FYSETC/FYSETC-Cheetah-v2/examples/README.md

# Example

On these examples, you can find wiring diagram, firmware configuration. 

## Voron 0.1

Details check [github](https://github.com/FYSETC/FYSETC-Voron-0/tree/main/Firmware%26OS) or [gitee](https://gitee.com/fysetc-mirrors/FYSETC-Voron-0).

## Creality Ender-3

Check the README in folder `Ender-3`.

## Creality CR-10

Check the README in folder `CR-10`.
