FYSETC/FYSETC-Cheetah-v2/firmware/README.md

# Firmware

Cheetah v2.0 support both [Marlin](https://github.com/MarlinFirmware) and [Klipper](https://github.com/Klipper3d/klipper) firmware.
