FYSETC/FYSETC-Cheetah-v2/examples/CR10/README.md

# CR-10

We provide you an basic Marlin 2.0.9.3 based firmware(`firmware.bin`) for you, you can follow the instruction [here](https://github.com/FYSETC/FYSETC-Cheetah-v2#53--firmware-upload)( section) to upload the firmware, and we provide you its configuration files `configuration.h` and `configuration_adv.h`.

If you want to build the latest bugfix firmware, the configurations are [here](https://github.com/MarlinFirmware/Configurations/pull/682).

## Fan wiring

Connect controller fan to Cheetah2.x `FAN2` port
