FYSETC/FYSETC-Cheetah-v2/firmware/Klipper/README.md

# Klipper

## printer.cfg

This config is for our VORON 0.1 kit, you can change it base on your machine.
