FYSETC/FYSETC-Cheetah-v2/images/Cheetah_v20.png

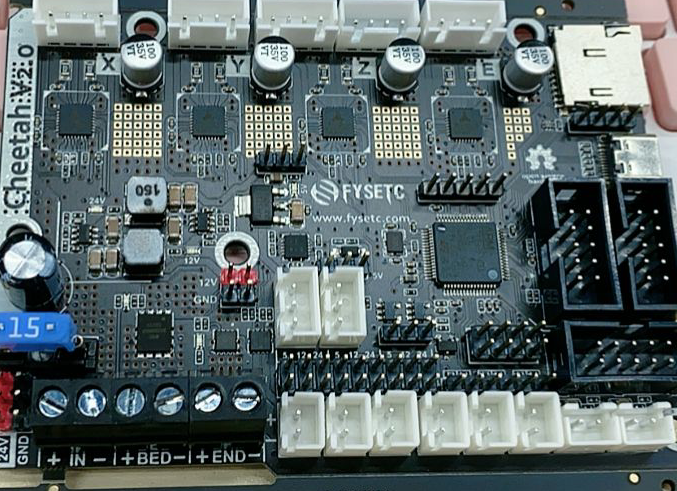
images/Cheetah_v20.png
