FYSETC/FYSETC-Cheetah-v2/(threads)

Thread 1 (2021-12-01):

#define PRINTCOUNTER: not worlking

Hagbard-84, 2021-12-01:
getting compile error:  Marlin\src\HAL\STM32\../../inc/../HAL/STM32/inc/SanityCheck.h:42:4: error: #error "Disable PRINTCOUNTER or choose another EEPROM emulation."

GerogeFu, 2021-12-01:
What version are you using ?

Hagbard-84, 2021-12-01:
latets marlin bugfix.

Hagbard-84, 2021-12-01:
the botloader: do i need to define in merlin ware i putt the firmware? if i build it from latest bugfix. ore do yhe boot loader place it att 0x08008000

Thread 2 (2021-12-15):

Connection issue with TFT24 v1.1

Morgan29880, 2021-12-15:
Hello,

I bought a Cheetah v2.0, that I would like to run with a TFT24 v1.1 screen. I managed to connect it in "Touch screen mod" (still got a "no printer attached" issue, but it's not a big deal I think).

What bothers me, i can't connect it either in "Marlin mode", with EXP1 and EXP2 ports...

I found EXP1 pin definition here, but does anyone have those for the other EXP ports please?

Thanks a lot.

GerogeFu, 2021-12-16:
Just update the pin def https://github.com/FYSETC/FYSETC-Cheetah-v2#43-pin-definition, and there is sch you can check https://github.com/FYSETC/FYSETC-Cheetah-v2/blob/main/hardware/Cheetah_Board%20V2.0_SCH.pdf

Morgan29880, 2021-12-16:
Thank you for your quick response.

yuriy-yarosh, 2022-06-26:
@Morgan29880 [this #2](https://github.com/FYSETC/FYSETC-Voron-0/issues/2) might be also helpful.

Thread 3 (2021-12-20):

mini lcd 12864 v2.1

petitphilou28, 2021-12-20:
hi,
i can switch on my fysetc lcd v2.1 on cheetah but nothing appear...

here is my setup...

[display]
lcd_type: uc1701
cs_pin: PB15
a0_pin: PB12
rst_pin: PB13
contrast: 63
encoder_pins: ^PC10, ^PC11
click_pin: ^!PC12
## Some micro-controller boards may require an spi bus to be specified:
#spi_bus: spi
## Alternatively, some micro-controller boards may work with software spi:
spi_software_miso_pin: PA6
spi_software_mosi_pin: PA7
spi_software_sclk_pin: PA5

#[output_pin beeper]
#pin: EXP2_10

[neopixel fysetc_mini12864]
pin: PB0
chain_count: 3
color_order: RGB
initial_RED: 0.1
initial_GREEN: 0.5
initial_BLUE: 0.0

[delayed_gcode setdisplayneopixel]
initial_duration: 1
gcode:
        SET_LED LED=fysetc_mini12864 RED=1 GREEN=1 BLUE=1 INDEX=1 TRANSMIT=0
        SET_LED LED=fysetc_mini12864 RED=1 GREEN=0 BLUE=0 INDEX=2 TRANSMIT=0
        SET_LED LED=fysetc_mini12864 RED=1 GREEN=0 BLUE=0 INDEX=3

lbibass, 2022-08-01:
How did you fix this?

Closed 2022-06-26.

Thread 4 (2022-01-20):

Getting Klipper to run on Ender3 hardware

webhdx, 2022-01-20:
Hello
I was looking for a new board for my first revision Ender 3 which used old  Creality v1.1.4 board. Of course my first choice was SKR Mini E3 v3 but then I found FYSETC Cheetah v2 which has a few advantages in my opinion. I want ahead and bought one.

I'm trying to get Klipper to run on my machine but I noticed the provided configuration files are not 100% correct for Ender3. I had to make a few changes:

```diff
@@ -1,129 +1,195 @@
 [mcu]
 ##	Obtain mcu value by "ls -l /dev/serial/by-id/"
-serial: /dev/serial/by-id/usb-Klipper_stm32f401xc_4C004E000C51383336383937-if00
+serial: /dev/serial/by-id/usb-Klipper_stm32f401xc_150036001951383336383937-if00

 [stepper_x]
 step_pin: PC0
-dir_pin: PC1
+dir_pin: !PC1
 enable_pin: !PA8
 rotation_distance: 40
 microsteps: 16
 endstop_pin: ^PB4
 position_endstop: 0
-position_max: 200
+position_max: 240
 homing_speed: 50

 [tmc2209 stepper_x]
 uart_pin: PA3
 tx_pin: PA2
 uart_address: 0
 run_current: 0.800
 hold_current: 0.500
 stealthchop_threshold: 250

 [stepper_y]
 step_pin: PC14
 dir_pin: !PC13
 enable_pin: !PC15
 rotation_distance: 40
 microsteps: 16
-endstop_pin: ^PB3
+endstop_pin: ^PC8
 position_endstop: 0
-position_max: 200
+position_max: 240
 homing_speed: 50

 [tmc2209 stepper_y]
 uart_pin: PA3
 tx_pin: PA2
 uart_address: 2
 run_current: 0.800
 hold_current: 0.500
 stealthchop_threshold: 250

 [stepper_z]
 step_pin: PB9
 dir_pin: PB8
 enable_pin: !PC2
 rotation_distance: 8
 microsteps: 16

endstop_pin: ^PB1
position_endstop: 0
position_max: 250

 [tmc2209 stepper_z]
 uart_pin: PA3
 tx_pin: PA2
 uart_address: 1
 run_current: 0.800
 hold_current: 0.500
 stealthchop_threshold: 5

 [extruder]
 step_pin: PB2
 dir_pin: !PA15
 enable_pin: !PD2
-rotation_distance: 33.500
+rotation_distance: 33.683
 microsteps: 16

 nozzle_diameter: 0.400
 filament_diameter: 1.750
 heater_pin: PC6
 sensor_type: EPCOS 100K B57560G104F
 sensor_pin: PC4
 control: pid
 pid_kp: 21.527
 pid_ki: 1.063
 pid_kd: 108.982
 min_temp: 0
 max_temp: 250

 [tmc2209 extruder]
 uart_pin: PA3
 tx_pin: PA2
 uart_address: 3
 run_current: 1.0
 hold_current: 0.500
 stealthchop_threshold: 5

 [heater_bed]
 heater_pin: PC7
 sensor_type: EPCOS 100K B57560G104F
 sensor_pin: PC5
 control: pid
 pid_kp: 54.027
 pid_ki: 0.770
 pid_kd: 948.182
 min_temp: 0
 max_temp: 130

 #fan for printed model FAN0
 [fan]
 pin: PA14

 #fan for hotend FAN1
-#[heater_fan my_nozzle_fan]
-#pin: PA13
+[heater_fan hotend_fan]
+pin: PA13
+heater: extruder
+heater_temp: 50.0
+
+#fan for mainboard FAN2
+[fan_generic mcu_fan]
+pin: PA1

 [printer]
 kinematics: cartesian
 max_velocity: 300
 max_accel: 3000
 max_z_velocity: 5
 max_z_accel: 100

 [board_pins]
 aliases:
     # EXP1 header
     EXP1_1=<5V>,  EXP1_3=<RST>, EXP1_5=PA7,  EXP1_7=PA4,  EXP1_9=PA5,
     EXP1_2=<GND>, EXP1_4=PC3,   EXP1_6=PC11, EXP1_8=PC10, EXP1_10=PA6,

     # EXP2 header
     EXP2_1=<5V>,  EXP2_3=PB7, EXP2_5=PB14, EXP2_7=PB12, EXP2_9=PC12,
     EXP2_2=<GND>, EXP2_4=PB6, EXP2_6=PB13, EXP2_8=PB15, EXP2_10=PC9,

     # EXP3 header
     EXP3_1=PC9,  EXP3_3=PC10, EXP3_5=PC11, EXP3_7=PB12, EXP3_9=<GND>,
     EXP3_2=PC12, EXP3_4=PB14, EXP3_6=PB13, EXP3_8=PB15, EXP3_10=<5V>
     # Pins EXP1_4, EXP1_8, EXP1_6 are also MISO, MOSI, SCK of bus "spi2"

+[display]
+lcd_type: st7920
+cs_pin: EXP3_7
+sclk_pin: EXP3_6
+sid_pin: EXP3_8
+encoder_pins: ^EXP3_5, ^EXP3_3
+click_pin: ^!EXP3_2
+
+[output_pin beeper]
+pin: EXP3_1
```

This is a good starting point if someone is struggling to get Ender3 hardware to work properly.

I have multiple isues though:
- I can't get internal MCU temperature sensor to work. Since Ender3 has additional fan for the mainboard I'd like to run it only if the temperature reaches some temperature. I tried configuring custom temperature sensor:
```ini
[temperature_sensor mcu_temp]
sensor_type: temperature_mcu
sensor_mcu: mcu
min_temp: 0
max_temp: 100
```

But I get `MCU 'mcu' shutdown: Not a valid ADC pin` error.
- Can't get BLTouch to work - this is the most frustrating one. I'm using v3.0 3D Touch clone on my setup and it was working properly with previous board. Now with Cheetah v2 Klipper can't control the probe, it doesn't react to any `BLTOUCH_DEBUG` commands. My config for BLTouch looks like this:
```ini
[bltouch]
sensor_pin = ^PB1
control_pin = PA0
x_offset: -45
y_offset: -8
z_offset: 3.2
samples: 2
speed: 10.0
probe_with_touch_mode: true
stow_on_each_sample: false
```

Any idea how to deal with these issues, especially BLTouch?

Thread 5 (2022-05-05):

MCU Temperature sensor

vjeko2404, 2022-05-05:
When I define the MCU temperature sensor in printer.cfg I get the MCU 'mcu' shutdown: Not a valid ADC pin error.
That should work with the STM32 pcu. Is the internal temp sensor included?

```
[temperature_sensor mcu_temp]
sensor_type: temperature_mcu
min_temp: 0
max_temp: 100
```

ayufan, 2022-06-13:
I created a fix in here: https://github.com/Klipper3d/klipper/pull/5572

Thread 7 (2022-07-01):

Cheetah V2 - Enable Printcount

V1ntex, 2022-07-01:
Hello, please help me, i want to enable PRINTCOUNT, but i take an error:

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

yzheka, 2022-09-30:
check [this](https://github.com/FYSETC/FYSETC-Cheetah-v2/issues/1). Actually you can see all in error message

Thread 8 (2022-09-04):

EXP1 and EXP2 are mirrored

RobTS, 2022-09-04:
After spending plenty of time trying to get one of your 12864 displays connected, I have figured out the reason: The mapping of EXP1 and EXP2 (and possibly EXP3 too, haven't checked) is inverted (e.g. 1 is 10, 10 is 1, and so on). When trying to set up your 12864 according to the [default klipper config for lcds](https://github.com/Klipper3d/klipper/blob/master/config/sample-lcd.cfg), this leads to klipper not being able to run due to errors such as `pin EXP1_3 is reserved for <RST>` preventing startup. When invering the pin headers, the display starts working flawlessly.

lbibass, 2022-11-11:
@RobTS do you happen to have your fixed config? Do you mind sending it here?

Thread 10 (2022-10-11):

BL touch wiring image is incorrect on main git page

PhilMaddox, 2022-10-11:
The image showing the connection for a BL touch is incorrect and will damage the BLT and / or control board !!!

this is what it should be >>
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

voronoff2803, 2023-03-18:
you should use the following config:
[bltouch]
sensor_pin: ^PA0
control_pin: PB1

Thread 11 (2022-10-17):

extruder thermistor is not accurate

yzheka, 2022-10-17:
on the tempertaure grapth the line is not straight and there are a lot +/-1 degree of celsius lag which causes inconsitent extrusion. after switching to skr pico with the same rest of hardware I can see +/- 0.2 degree of celsius lag.

Thread 12 (2023-01-05):

Example connection for neopixel

HitLuca, 2023-01-05:
In the readme there is a mention of neopixel support, but there is no indication of where it should be used. It is also mentioned that the board pins can be used as 4th fan, but still no 2-pin connector that seems suitable can be seen in the pictures

Thread 13 (2023-02-15):

Cheetah-v2 short?

Yuxiang-Ma, 2023-02-15:
I am using Cheetash-v2 as control board for Voron 0.1. I found that the heaters does not work and the cooling fans will not start when I was running the intial startup for voron 0.1.

I tested the output pins of the cheetah-v2 board, and both the power and ground pins for heaters and cooling fans give me 24V. Then I turn off the power and tested the resistance of those pins. It seems they are all good and no short is happening.

I am really not sure if there is a short happening, since the reisistances are normal and I do not think there was any magic gas leaking when I first boot the board. So I am not sure about what to do. Is there anything I can do to find out the issue? Or should I just buy a new board?

Thread 15 (2023-03-12):

Fan pins are flipped

Petertjedmn, 2023-03-12:
+ and - of the fans are the flipped. I solved this on my board by just flipping the white sockets for the fans. You can get them off the board with tweezers.

voronoff2803, 2023-03-18:
you should use the following config:
[bltouch]
sensor_pin: ^PA0
control_pin: PB1

Thread 16 (2023-03-19):

Difference between 5V, DC5V and USB_5V?

kozross, 2023-03-19:
The image below shows three power pins that are grouped on the board:

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

I'm unable to tell what the difference between these pins is. They all seem to do the same thing: provide 5V power. However, they're separate, and named differently, so what exactly is the difference, if any?

Context for this question: I am trying to power a SBC running Klipper, and would like to know which of these pins I can use for 5V power.

Thread 17 (2024-02-03):

Wiki shows wrong pinout (RGB and PWR-PROBE flipped)

devdrik, 2024-02-03:
The wiki for the cheetah 2 shows a wrong pinout:
In [this wiki](https://wiki.fysetc.com/Cheetah_Board_V20/#43-pin-definition) the [pinout image](https://wiki.fysetc.com/images/Cheetah_V2.0_pinout.jpg) has the RGB and PWR-PROBE pins switched. This lead to me killing my LEDs. The GitHub readme already has a correct version of the image [this one](https://github.com/FYSETC/FYSETC-Cheetah-v2/blob/main/images/Cheetah_V2.0_pinout.jpg)

Please update the wiki!

ashthespy, 2024-03-21:
@devdrik Did you get manage to get this working? I ran into the same issue, and thankfully didn't manage to shot out my LEDs.
LEDs work fine on other MCUs, but I couldn't get it working with klipper. Any hints?

devdrik, 2024-03-21:
@ashthespy Yes, when I used the correct pins ([this picture shows the correct LED pins](https://github.com/FYSETC/FYSETC-Cheetah-v2/blob/main/images/Cheetah_V2.0_pinout.jpg)) everything worked fine.
