FYSETC/FYSETC-Cheetah-v2/hardware/Cheetah_Board V2.0_SCH.pdf

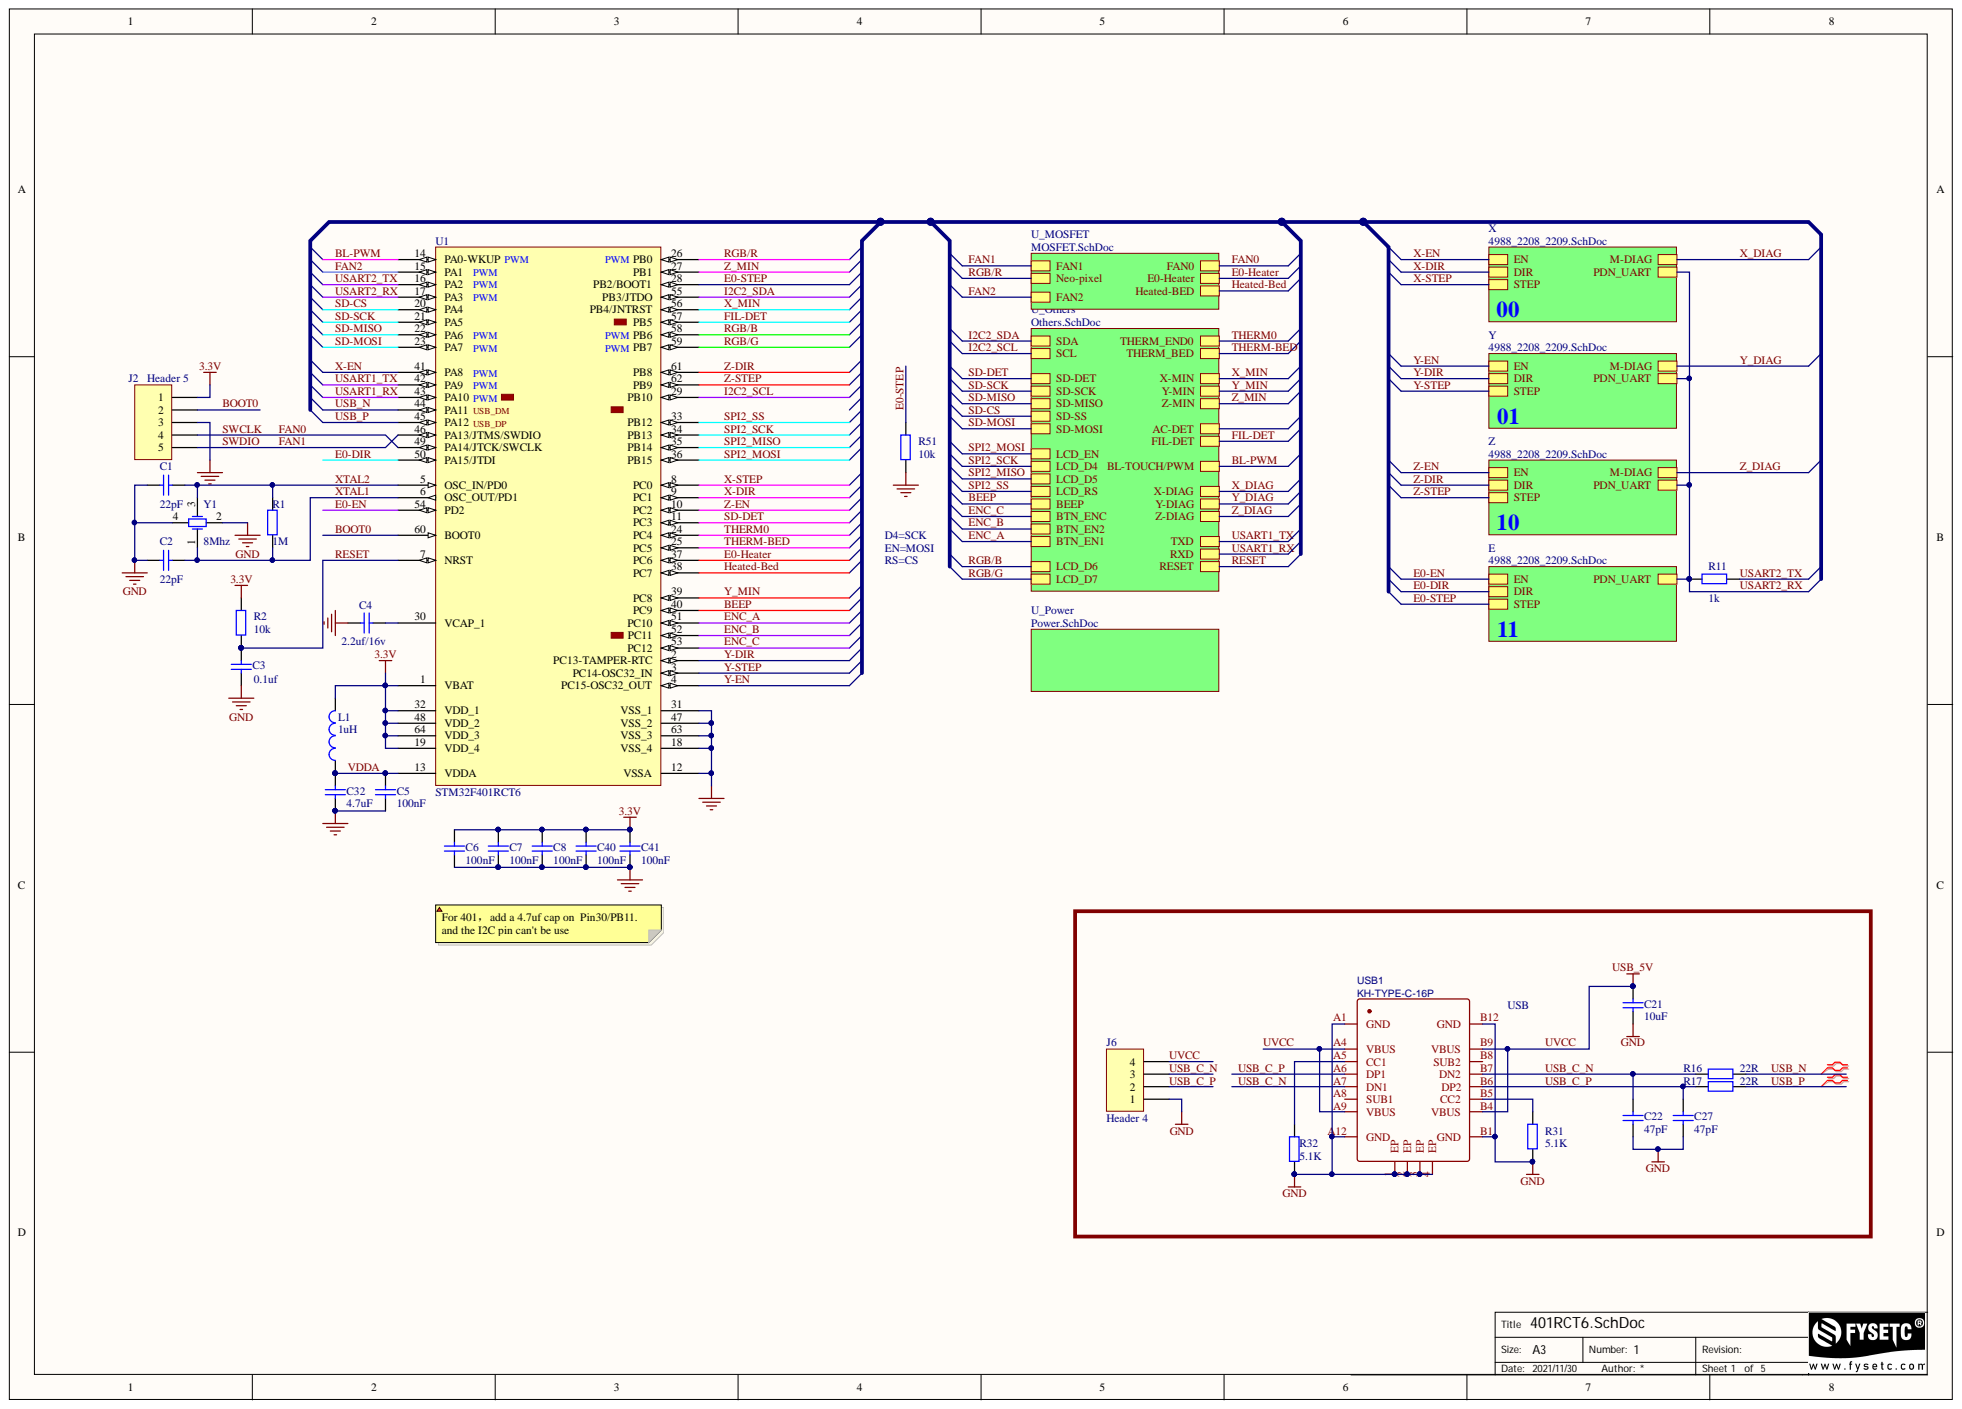
[picture p11: page 1]

For 401，add a 4.7uf cap on Pin30/PB11.
and the I2C pin can't be use

401RCT6.SchDoc Title

Size: A3 | Number: | Revision:

Date: Author: | | Sheet of

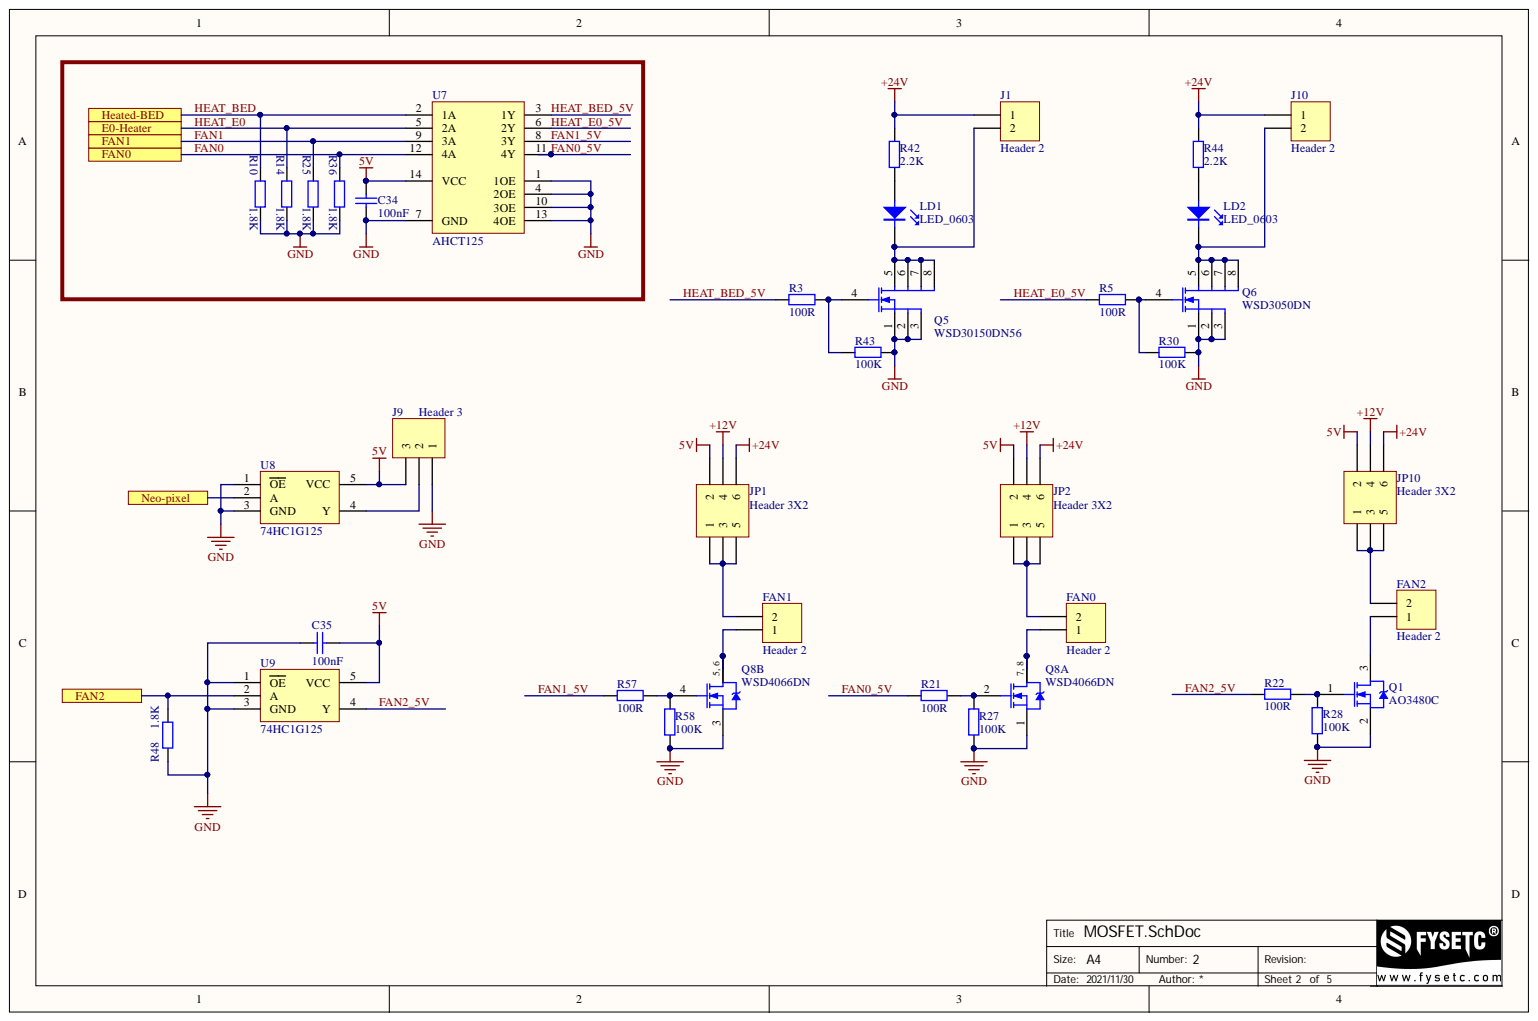
[picture p12: page 2]

HEAT_E0
FAN1
FAN0

5V | VCC 14

MOSFET.SchDoc Title

Size: A4 | Number: 2 | Revision:

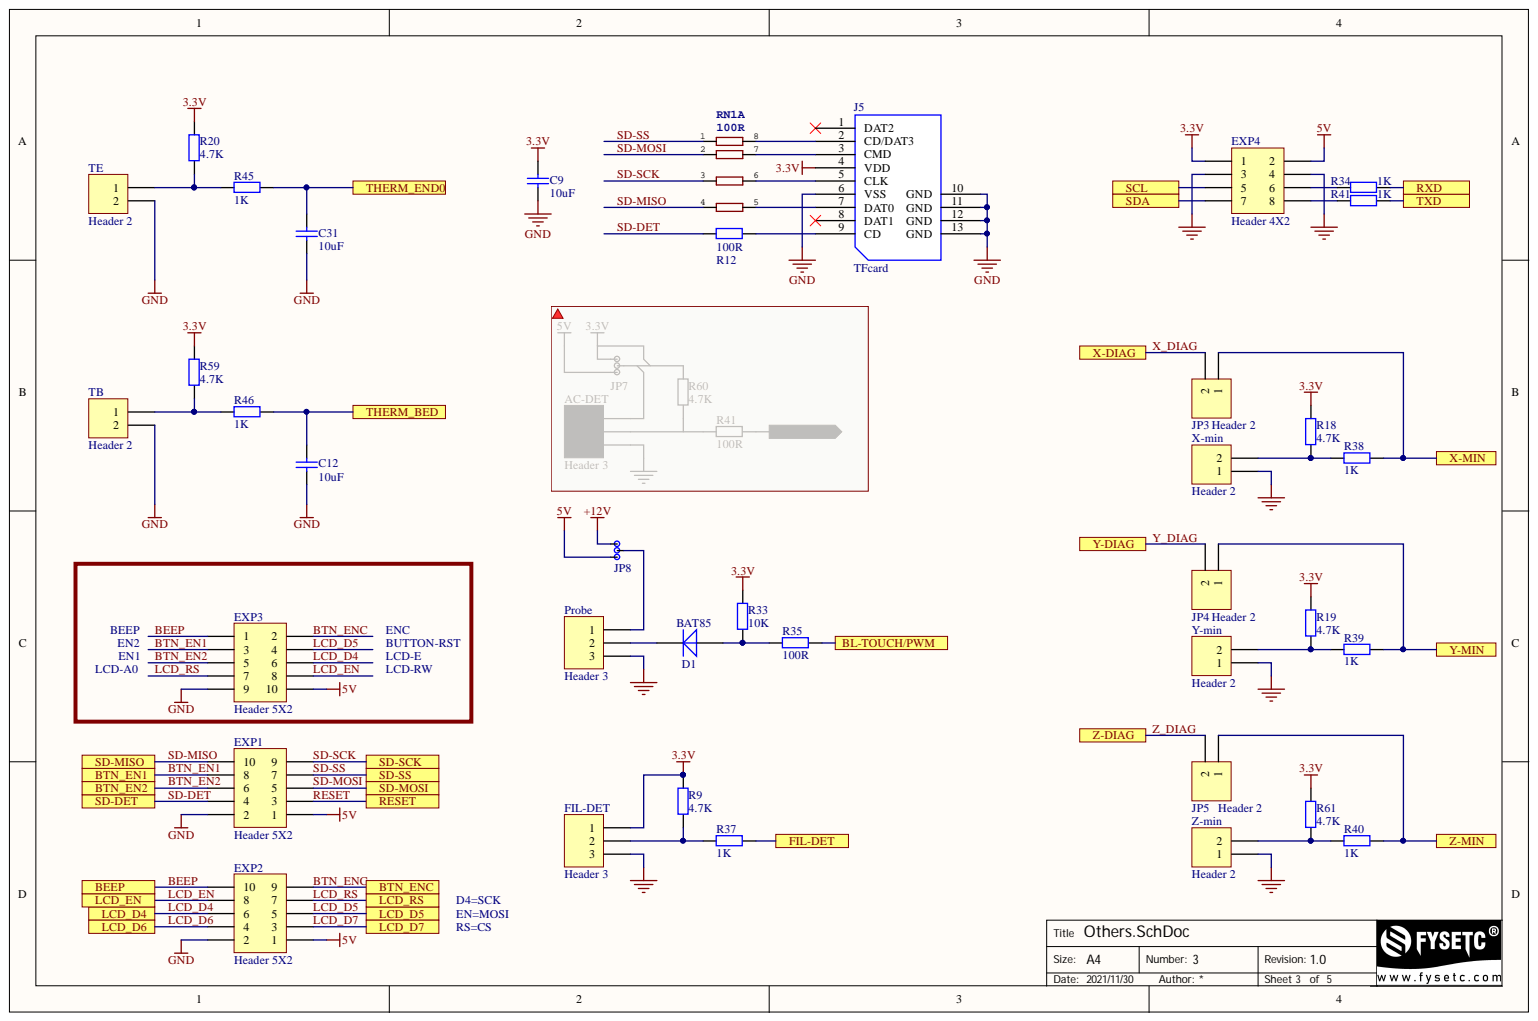
[picture p13: page 3]

SDA | TXD

BTN_EN2 | SD-MOSI
SD-DET | RESET

LCD_EN | | LCD_RS
LCD_D4 | | LCD_D5
LCD_D6 | | LCD_D7

LCD_D4 | | | | LCD_D5

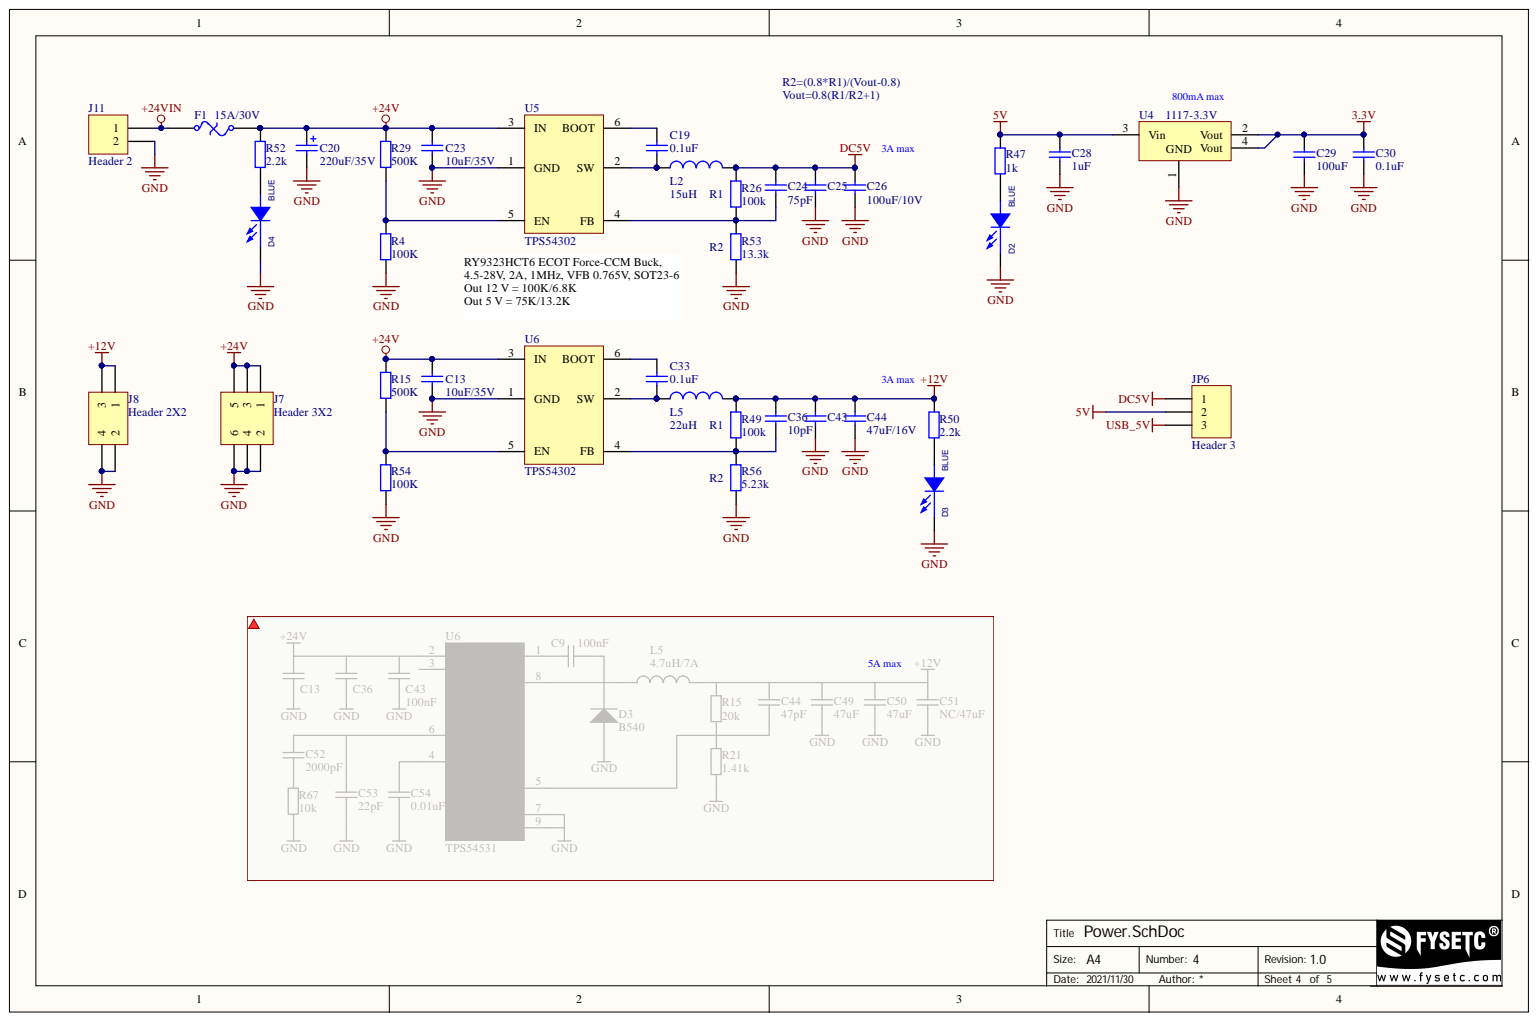
[picture p14: page 4]

Power.SchDoc Title

Size: A4 | Number: 4 | Revision: 1.0

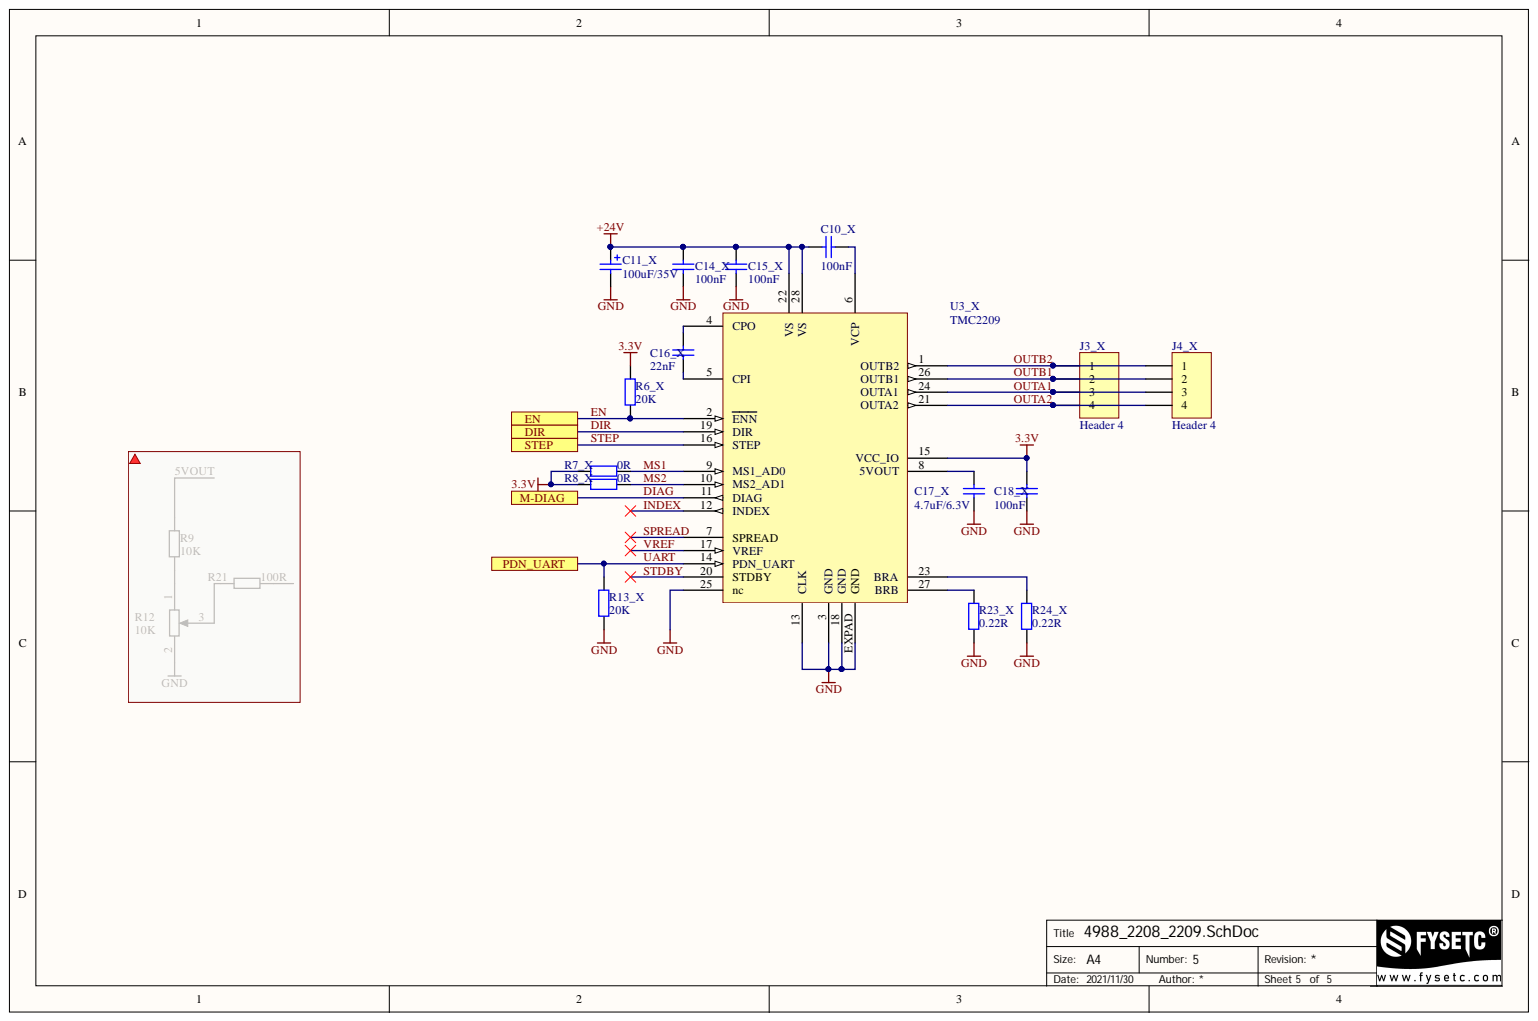
[picture p15: page 5]

4988_2208_2209.SchDoc Title

Size: A4 | Number: 5 | Revision: *

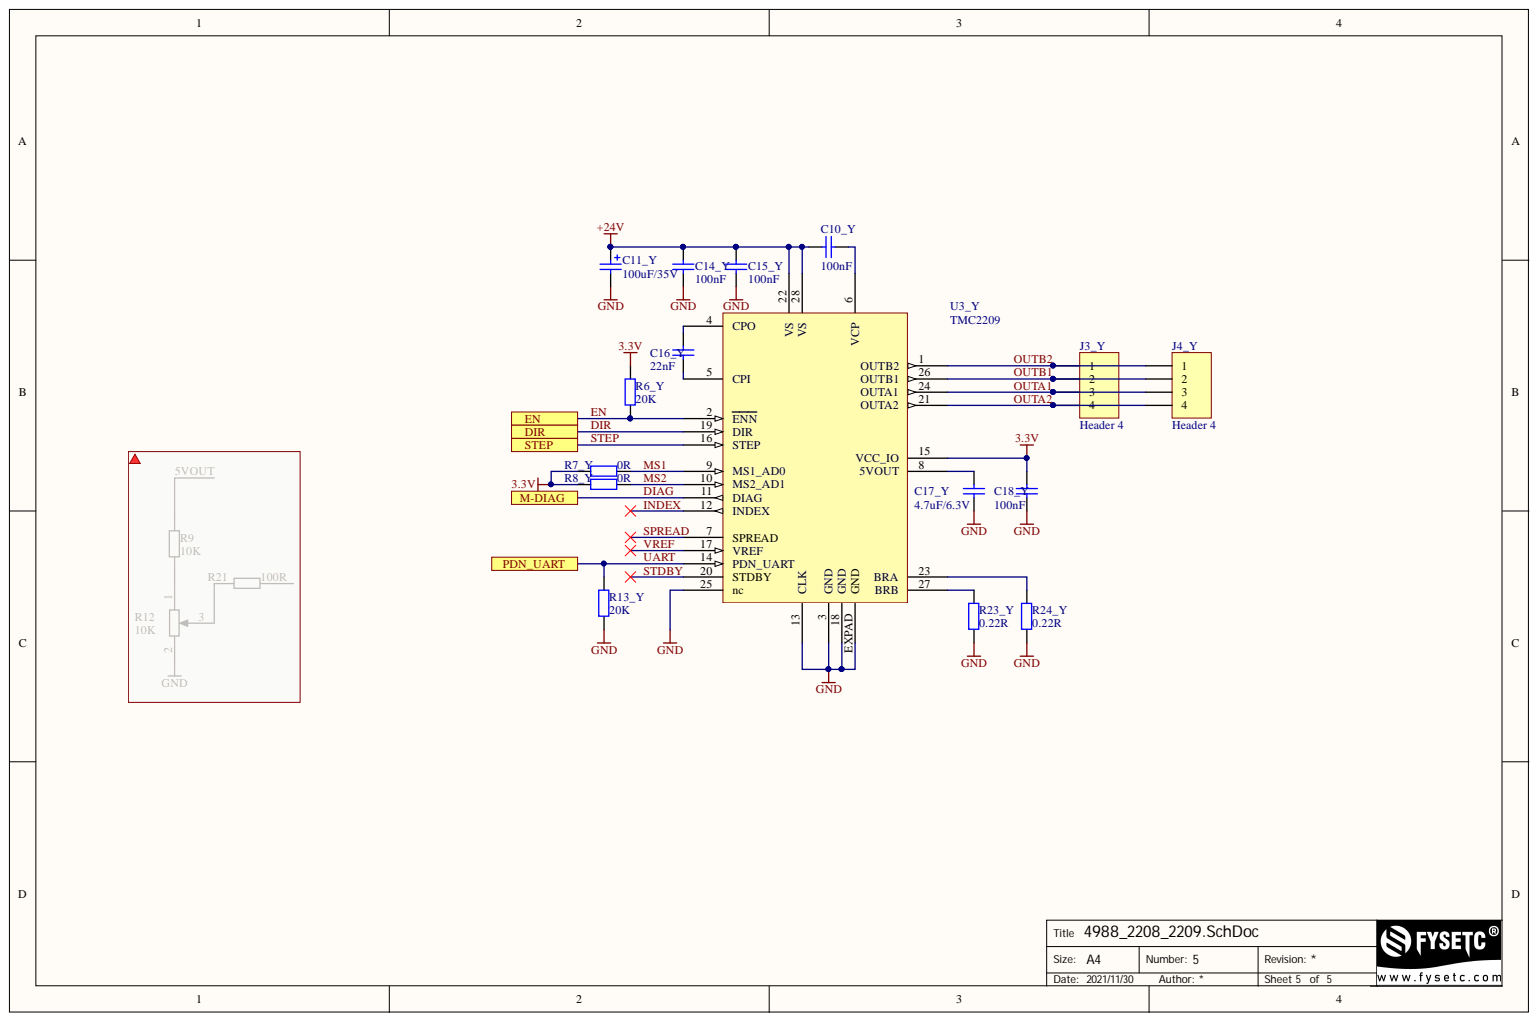
[picture p16: page 6]

4988_2208_2209.SchDoc Title

Size: A4 | Number: 5 | Revision: *

4988_2208_2209.SchDoc Title

Size: A4 | Number: 5 | Revision: *

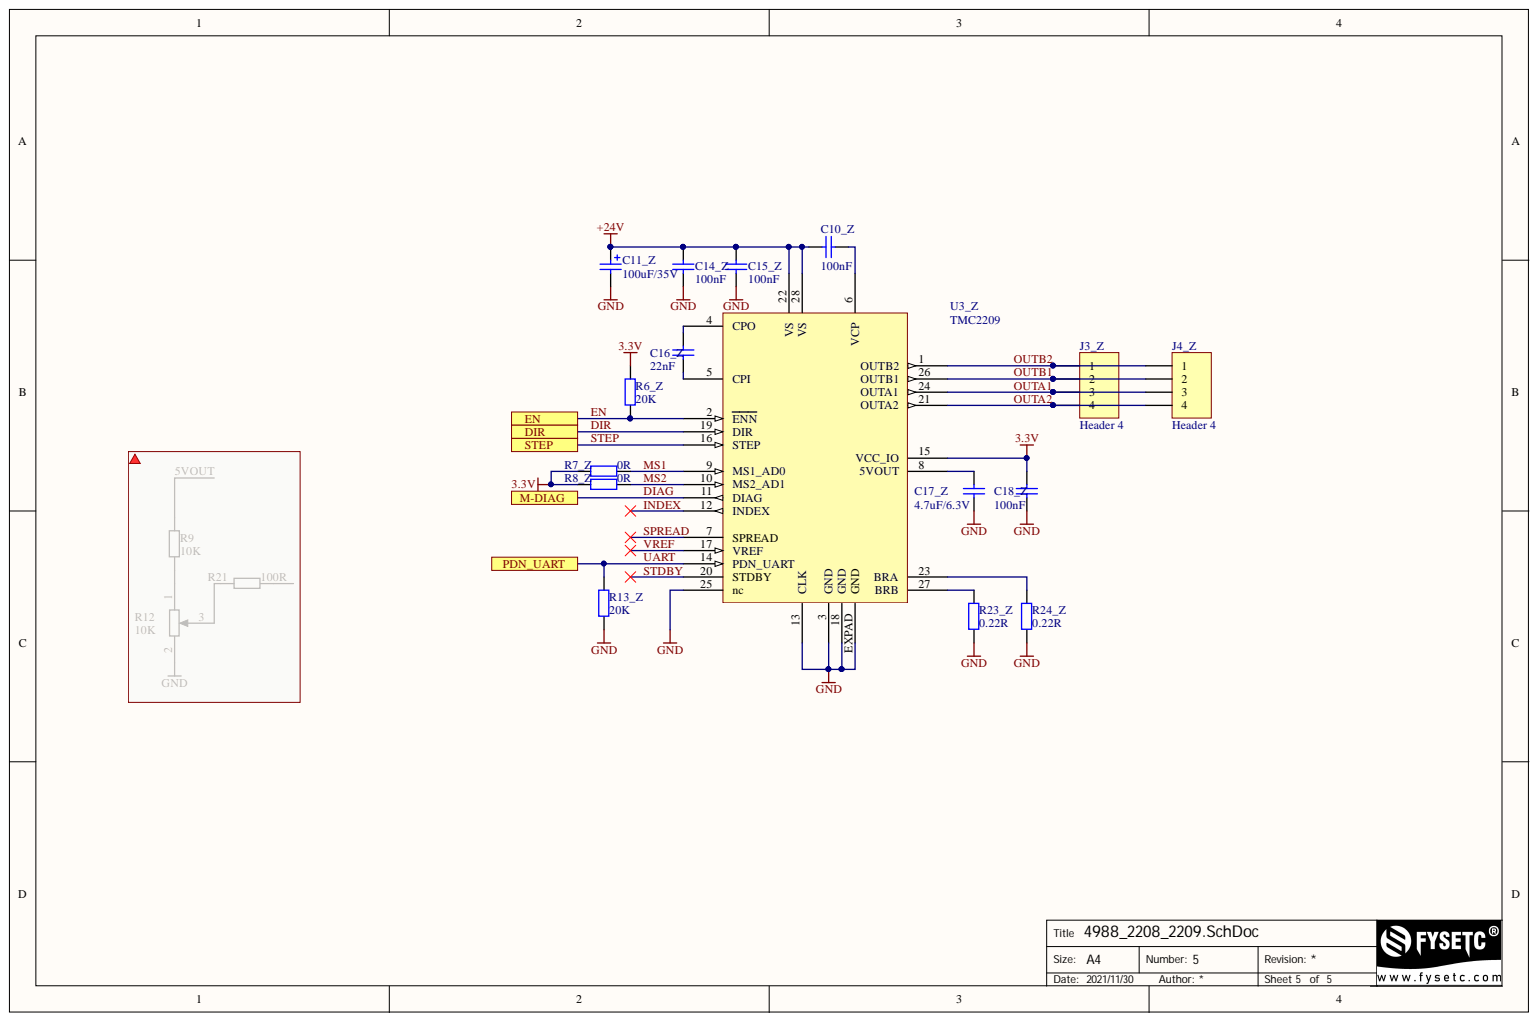
[picture p17: page 8]

4988_2208_2209.SchDoc Title

Size: A4 | Number: 5 | Revision: *
