FYSETC/FYSETC-Cheetah-v2/hardware/Composite Drawing.pdf

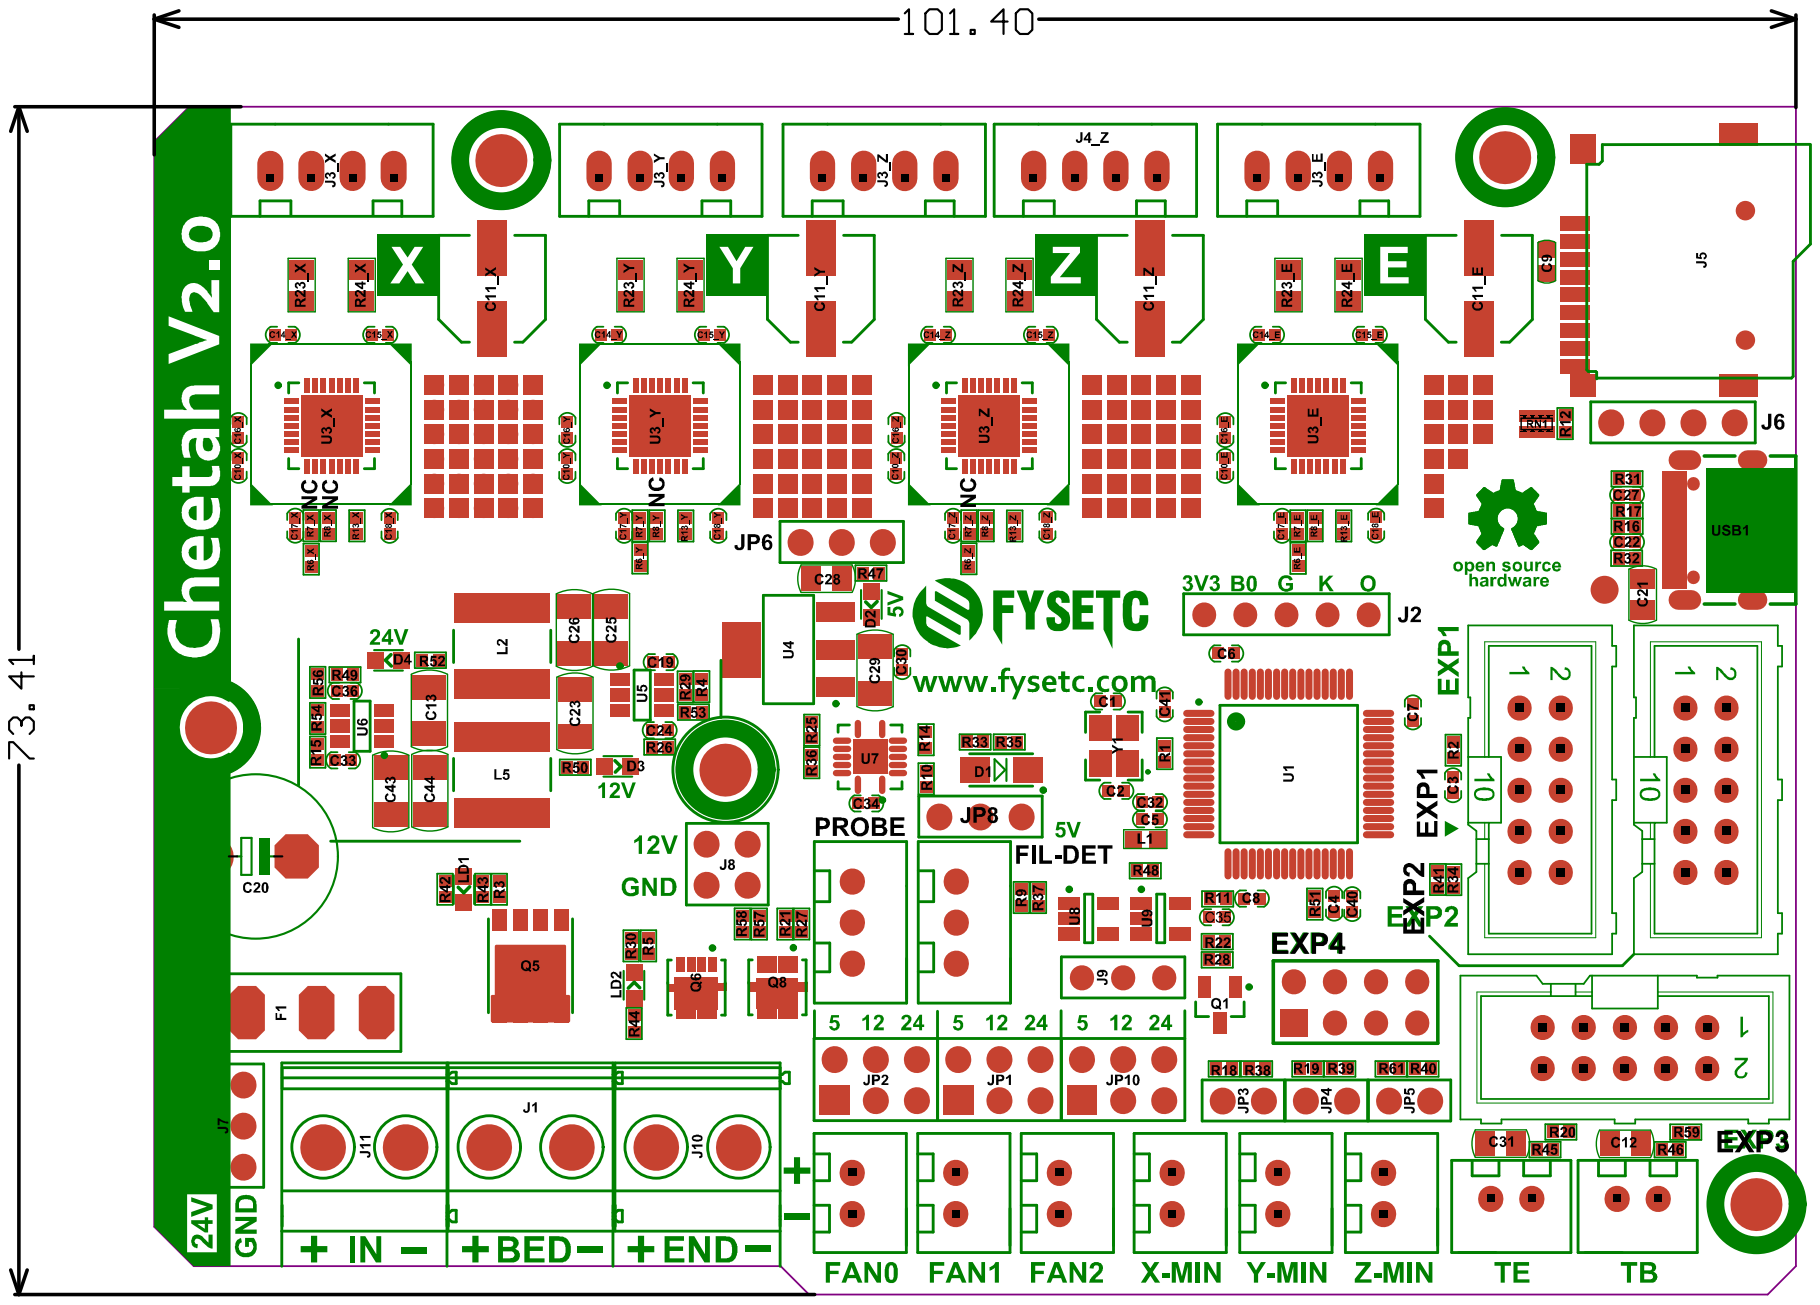
[picture p18: page 1]

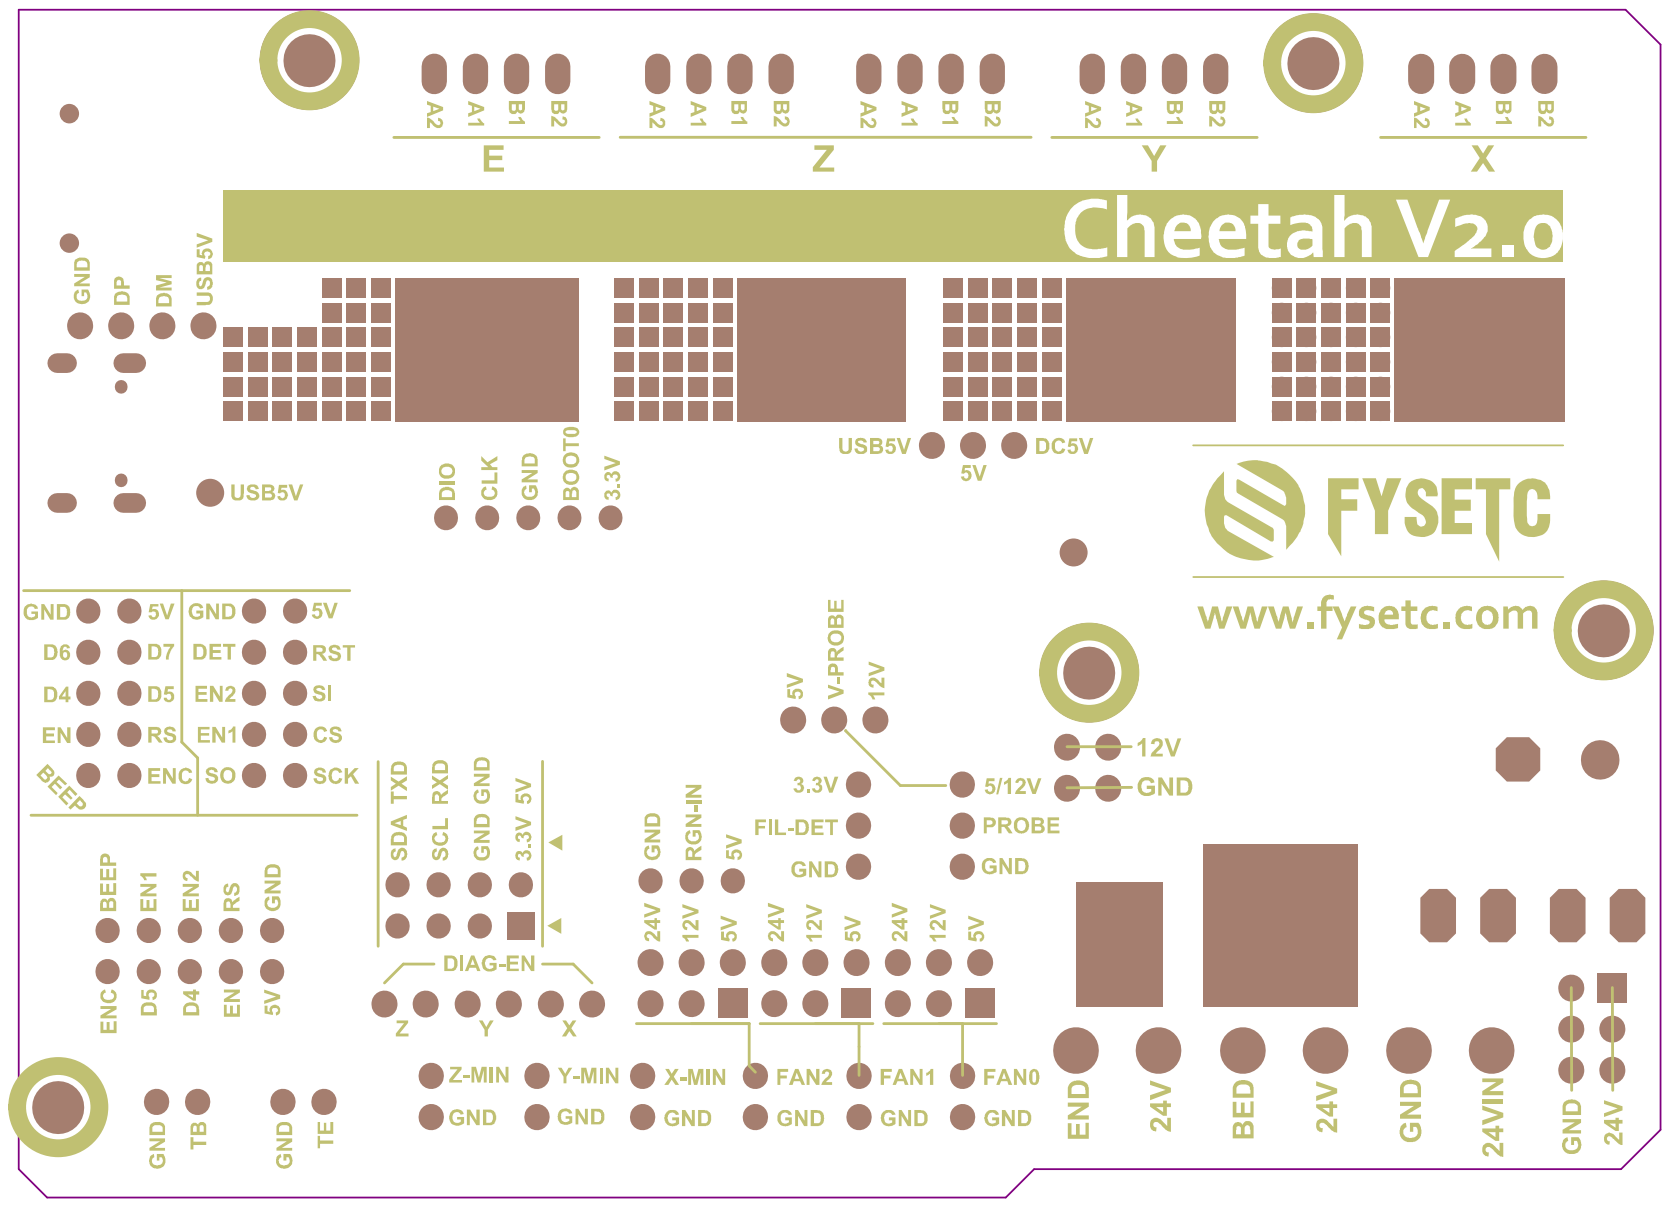
[picture p19: page 2]
