FYSETC/FYSETC-Cheetah-v2/firmware/Marlin/Marlin/Marlin/Configuration.h

#pragma once
#define CONFIGURATION_H_VERSION 02000902
#define STRING_CONFIG_H_AUTHOR "(none, default config)" // Who made the changes.
#define SHOW_BOOTSCREEN
#define SERIAL_PORT -1
#define BAUDRATE 115200
  #define MOTHERBOARD BOARD_FYSETC_CHEETAH_V20
#if LINEAR_AXES >= 4
  #define AXIS4_NAME 'A' // :['A', 'B', 'C', 'U', 'V', 'W']
#endif
#if LINEAR_AXES >= 5
  #define AXIS5_NAME 'B' // :['A', 'B', 'C', 'U', 'V', 'W']
#endif
#if LINEAR_AXES >= 6
  #define AXIS6_NAME 'C' // :['A', 'B', 'C', 'U', 'V', 'W']
#endif
#define EXTRUDERS 1
#define DEFAULT_NOMINAL_FILAMENT_DIA 1.75
#define TEMP_SENSOR_0 1
#define TEMP_SENSOR_1 0
#define TEMP_SENSOR_2 0
#define TEMP_SENSOR_3 0
#define TEMP_SENSOR_4 0
#define TEMP_SENSOR_5 0
#define TEMP_SENSOR_6 0
#define TEMP_SENSOR_7 0
#define TEMP_SENSOR_BED 0
#define TEMP_SENSOR_PROBE 0
#define TEMP_SENSOR_CHAMBER 0
#define TEMP_SENSOR_COOLER 0
#define TEMP_SENSOR_BOARD 0
#define TEMP_SENSOR_REDUNDANT 0
#define DUMMY_THERMISTOR_998_VALUE  25
#define DUMMY_THERMISTOR_999_VALUE 100
#define TEMP_RESIDENCY_TIME         10  // (seconds) Time to wait for hotend to "settle" in M109
#define TEMP_WINDOW                  1  // (°C) Temperature proximity for the "temperature reached" timer
#define TEMP_HYSTERESIS              3  // (°C) Temperature proximity considered "close enough" to the target
#define TEMP_BED_RESIDENCY_TIME     10  // (seconds) Time to wait for bed to "settle" in M190
#define TEMP_BED_WINDOW              1  // (°C) Temperature proximity for the "temperature reached" timer
#define TEMP_BED_HYSTERESIS          3  // (°C) Temperature proximity considered "close enough" to the target
#define TEMP_CHAMBER_RESIDENCY_TIME 10  // (seconds) Time to wait for chamber to "settle" in M191
#define TEMP_CHAMBER_WINDOW          1  // (°C) Temperature proximity for the "temperature reached" timer
#define TEMP_CHAMBER_HYSTERESIS      3  // (°C) Temperature proximity considered "close enough" to the target
#if TEMP_SENSOR_REDUNDANT
  #define TEMP_SENSOR_REDUNDANT_SOURCE    E1  // The sensor that will provide the redundant reading.
  #define TEMP_SENSOR_REDUNDANT_TARGET    E0  // The sensor that we are providing a redundant reading for.
  #define TEMP_SENSOR_REDUNDANT_MAX_DIFF  10  // (°C) Temperature difference that will trigger a print abort.
#endif
#define HEATER_0_MINTEMP   5
#define HEATER_1_MINTEMP   5
#define HEATER_2_MINTEMP   5
#define HEATER_3_MINTEMP   5
#define HEATER_4_MINTEMP   5
#define HEATER_5_MINTEMP   5
#define HEATER_6_MINTEMP   5
#define HEATER_7_MINTEMP   5
#define BED_MINTEMP        5
#define CHAMBER_MINTEMP    5
#define HEATER_0_MAXTEMP 275
#define HEATER_1_MAXTEMP 275
#define HEATER_2_MAXTEMP 275
#define HEATER_3_MAXTEMP 275
#define HEATER_4_MAXTEMP 275
#define HEATER_5_MAXTEMP 275
#define HEATER_6_MAXTEMP 275
#define HEATER_7_MAXTEMP 275
#define BED_MAXTEMP      150
#define CHAMBER_MAXTEMP  60
#define HOTEND_OVERSHOOT 15   // (°C) Forbid temperatures over MAXTEMP - OVERSHOOT
#define BED_OVERSHOOT    10   // (°C) Forbid temperatures over MAXTEMP - OVERSHOOT
#define COOLER_OVERSHOOT  2   // (°C) Forbid temperatures closer than OVERSHOOT
#define PIDTEMP
#define BANG_MAX 255     // Limits current to nozzle while in bang-bang mode; 255=full current
#define PID_MAX BANG_MAX // Limits current to nozzle while PID is active (see PID_FUNCTIONAL_RANGE below); 255=full current
#define PID_K1 0.95      // Smoothing factor within any PID loop
    #define DEFAULT_Kp  22.20
    #define DEFAULT_Ki   1.08
    #define DEFAULT_Kd 114.00
#define MAX_BED_POWER 255 // limits duty cycle to bed; 255=full current
#define MAX_CHAMBER_POWER 255 // limits duty cycle to chamber heater; 255=full current
  #define PID_FUNCTIONAL_RANGE 10 // If the temperature difference between the target temperature and the actual temperature
#define PREVENT_COLD_EXTRUSION
#define EXTRUDE_MINTEMP 170
#define PREVENT_LENGTHY_EXTRUDE
#define EXTRUDE_MAXLENGTH 200
#define THERMAL_PROTECTION_HOTENDS // Enable thermal protection for all extruders
#define THERMAL_PROTECTION_BED     // Enable thermal protection for the heated bed
#define THERMAL_PROTECTION_CHAMBER // Enable thermal protection for the heated chamber
#define THERMAL_PROTECTION_COOLER  // Enable thermal protection for the laser cooling
#define USE_XMIN_PLUG
#define USE_YMIN_PLUG
#define USE_ZMIN_PLUG
#define ENDSTOPPULLUPS
#define X_MIN_ENDSTOP_INVERTING false // Set to true to invert the logic of the endstop.
#define Y_MIN_ENDSTOP_INVERTING false // Set to true to invert the logic of the endstop.
#define Z_MIN_ENDSTOP_INVERTING false // Set to true to invert the logic of the endstop.
#define I_MIN_ENDSTOP_INVERTING false // Set to true to invert the logic of the endstop.
#define J_MIN_ENDSTOP_INVERTING false // Set to true to invert the logic of the endstop.
#define K_MIN_ENDSTOP_INVERTING false // Set to true to invert the logic of the endstop.
#define X_MAX_ENDSTOP_INVERTING false // Set to true to invert the logic of the endstop.
#define Y_MAX_ENDSTOP_INVERTING false // Set to true to invert the logic of the endstop.
#define Z_MAX_ENDSTOP_INVERTING false // Set to true to invert the logic of the endstop.
#define I_MAX_ENDSTOP_INVERTING false // Set to true to invert the logic of the endstop.
#define J_MAX_ENDSTOP_INVERTING false // Set to true to invert the logic of the endstop.
#define K_MAX_ENDSTOP_INVERTING false // Set to true to invert the logic of the endstop.
#define Z_MIN_PROBE_ENDSTOP_INVERTING false // Set to true to invert the logic of the probe.
#define X_DRIVER_TYPE  TMC2209
#define Y_DRIVER_TYPE  TMC2209
#define Z_DRIVER_TYPE  TMC2209
#define E0_DRIVER_TYPE TMC2209
#define DEFAULT_AXIS_STEPS_PER_UNIT   { 80, 80, 400, 500 }
#define DEFAULT_MAX_FEEDRATE          { 300, 300, 5, 25 }
#define DEFAULT_MAX_ACCELERATION      { 3000, 3000, 100, 10000 }
#define DEFAULT_ACCELERATION          3000    // X, Y, Z and E acceleration for printing moves
#define DEFAULT_RETRACT_ACCELERATION  3000    // E acceleration for retracts
#define DEFAULT_TRAVEL_ACCELERATION   3000    // X, Y, Z acceleration for travel (non printing) moves
#define DEFAULT_EJERK    5.0  // May be used by Linear Advance
  #define JUNCTION_DEVIATION_MM 0.013 // (mm) Distance from real junction edge
  #define JD_HANDLE_SMALL_SEGMENTS    // Use curvature estimation instead of just the junction angle
#define Z_MIN_PROBE_USES_Z_MIN_ENDSTOP_PIN
#define BLTOUCH
#define NOZZLE_TO_PROBE_OFFSET { 10, 10, 0 }
#define PROBING_MARGIN 10
#define XY_PROBE_FEEDRATE (133*60)
#define Z_PROBE_FEEDRATE_FAST (4*60)
#define Z_PROBE_FEEDRATE_SLOW (Z_PROBE_FEEDRATE_FAST / 2)
#define Z_CLEARANCE_DEPLOY_PROBE   10 // Z Clearance for Deploy/Stow
#define Z_CLEARANCE_BETWEEN_PROBES  5 // Z Clearance between probe points
#define Z_CLEARANCE_MULTI_PROBE     5 // Z Clearance between multiple probes
#define Z_PROBE_LOW_POINT          -2 // Farthest distance below the trigger-point to go before stopping
#define Z_PROBE_OFFSET_RANGE_MIN -20
#define Z_PROBE_OFFSET_RANGE_MAX 20
#define X_ENABLE_ON 0
#define Y_ENABLE_ON 0
#define Z_ENABLE_ON 0
#define E_ENABLE_ON 0 // For all extruders
#define DISABLE_X false
#define DISABLE_Y false
#define DISABLE_Z false
#define DISABLE_E false             // Disable the extruder when not stepping
#define DISABLE_INACTIVE_EXTRUDER   // Keep only the active extruder enabled
#define INVERT_X_DIR false
#define INVERT_Y_DIR true
#define INVERT_Z_DIR false
#define INVERT_E0_DIR false
#define INVERT_E1_DIR false
#define INVERT_E2_DIR false
#define INVERT_E3_DIR false
#define INVERT_E4_DIR false
#define INVERT_E5_DIR false
#define INVERT_E6_DIR false
#define INVERT_E7_DIR false
#define X_HOME_DIR -1
#define Y_HOME_DIR -1
#define Z_HOME_DIR -1
#define X_BED_SIZE 200
#define Y_BED_SIZE 200
#define X_MIN_POS 0
#define Y_MIN_POS 0
#define Z_MIN_POS 0
#define X_MAX_POS X_BED_SIZE
#define Y_MAX_POS Y_BED_SIZE
#define Z_MAX_POS 200
#define MIN_SOFTWARE_ENDSTOPS
  #define MIN_SOFTWARE_ENDSTOP_X
  #define MIN_SOFTWARE_ENDSTOP_Y
  #define MIN_SOFTWARE_ENDSTOP_Z
  #define MIN_SOFTWARE_ENDSTOP_I
  #define MIN_SOFTWARE_ENDSTOP_J
  #define MIN_SOFTWARE_ENDSTOP_K
#define MAX_SOFTWARE_ENDSTOPS
  #define MAX_SOFTWARE_ENDSTOP_X
  #define MAX_SOFTWARE_ENDSTOP_Y
  #define MAX_SOFTWARE_ENDSTOP_Z
  #define MAX_SOFTWARE_ENDSTOP_I
  #define MAX_SOFTWARE_ENDSTOP_J
  #define MAX_SOFTWARE_ENDSTOP_K
#define HOMING_FEEDRATE_MM_M { (50*60), (50*60), (4*60) }
#define VALIDATE_HOMING_ENDSTOPS
#define EEPROM_CHITCHAT       // Give feedback on EEPROM commands. Disable to save PROGMEM.
#define EEPROM_BOOT_SILENT    // Keep M503 quiet and only give errors during first load
#define HOST_KEEPALIVE_FEATURE        // Disable this if your host doesn't like keepalive messages
#define DEFAULT_KEEPALIVE_INTERVAL 2  // Number of seconds between "busy" messages. Set with M113.
#define BUSY_WHILE_HEATING            // Some hosts require "busy" messages even during heating
#define PREHEAT_1_LABEL       "PLA"
#define PREHEAT_1_TEMP_HOTEND 180
#define PREHEAT_1_TEMP_BED     70
#define PREHEAT_1_TEMP_CHAMBER 35
#define PREHEAT_1_FAN_SPEED     0 // Value from 0 to 255
#define PREHEAT_2_LABEL       "ABS"
#define PREHEAT_2_TEMP_HOTEND 240
#define PREHEAT_2_TEMP_BED    110
#define PREHEAT_2_TEMP_CHAMBER 35
#define PREHEAT_2_FAN_SPEED     0 // Value from 0 to 255
#define PRINTJOB_TIMER_AUTOSTART
#define LCD_LANGUAGE en
#define DISPLAY_CHARSET_HD44780 JAPANESE
#define LCD_INFO_SCREEN_STYLE 0
#define SPEAKER
#define FYSETC_MINI_12864_2_1    // Type A/B. NeoPixel RGB Backlight
#define SOFT_PWM_SCALE 0
#define SERVO_DELAY { 300 }
