FYSETC/FYSETC-Cheetah-v2/firmware/Klipper/generic-fysetc-cheetah-v2.0.cfg

# This file contains common pin mappings for the Fysetc Cheetah v2.0
# board. To use this config, the firmware should be compiled for the
# STM32F401 with "No bootloader" and Communication interface USB

# After running "make", run the following command to flash the board:
# dfu-util -R -a 0 -s 0x08000000:leave -D out/klipper.bin

# See docs/Config_Reference.md for a description of parameters.

[mcu]
##	Obtain mcu value by "ls -l /dev/serial/by-id/" 
serial: /dev/serial/by-id/usb-Klipper_stm32f401xc_4C004E000C51383336383937-if00

[stepper_x]
step_pin: PC0
dir_pin: PC1
enable_pin: !PA8
rotation_distance: 40
microsteps: 16
endstop_pin: ^PB4
position_endstop: 0
position_max: 200
homing_speed: 50

[tmc2209 stepper_x]
uart_pin: PA3
tx_pin: PA2
uart_address: 0
run_current: 0.800
hold_current: 0.500
stealthchop_threshold: 250

[stepper_y]
step_pin: PC14
dir_pin: !PC13
enable_pin: !PC15
rotation_distance: 40
microsteps: 16
endstop_pin: ^PC8
position_endstop: 0
position_max: 200
homing_speed: 50

[tmc2209 stepper_y]
uart_pin: PA3
tx_pin: PA2
uart_address: 2
run_current: 0.800
hold_current: 0.500
stealthchop_threshold: 250

[stepper_z]
step_pin: PB9
dir_pin: PB8
enable_pin: !PC2
rotation_distance: 8
microsteps: 16

endstop_pin: ^PB1
position_endstop: 0
position_max: 200

[tmc2209 stepper_z]
uart_pin: PA3
tx_pin: PA2
uart_address: 1
run_current: 0.800
hold_current: 0.500
stealthchop_threshold: 5

[extruder]
step_pin: PB2
dir_pin: !PA15
enable_pin: !PD2
rotation_distance: 33.500
microsteps: 16

nozzle_diameter: 0.400
filament_diameter: 1.750
heater_pin: PC6
sensor_type: EPCOS 100K B57560G104F
sensor_pin: PC4
control: pid
pid_kp: 21.527
pid_ki: 1.063
pid_kd: 108.982
min_temp: 0
max_temp: 250

[tmc2209 extruder]
uart_pin: PA3
tx_pin: PA2
uart_address: 3
run_current: 1.0
hold_current: 0.500
stealthchop_threshold: 5

[heater_bed]
heater_pin: PC7
sensor_type: EPCOS 100K B57560G104F
sensor_pin: PC5
control: pid
pid_kp: 54.027
pid_ki: 0.770
pid_kd: 948.182
min_temp: 0
max_temp: 130

#fan for printed model FAN0
[fan]
pin: PA14

#fan for hotend FAN1
#[heater_fan my_nozzle_fan]
#pin: PA13

[printer]
kinematics: cartesian
max_velocity: 300
max_accel: 3000
max_z_velocity: 5
max_z_accel: 100

[board_pins]
aliases:
    # EXP1 header
    EXP1_1=<5V>,  EXP1_3=<RST>, EXP1_5=PA7,  EXP1_7=PA4,  EXP1_9=PA5,
    EXP1_2=<GND>, EXP1_4=PC3,   EXP1_6=PC11, EXP1_8=PC10, EXP1_10=PA6,

    # EXP2 header
    EXP2_1=<5V>,  EXP2_3=PB7, EXP2_5=PB14, EXP2_7=PB12, EXP2_9=PC12,
    EXP2_2=<GND>, EXP2_4=PB6, EXP2_6=PB13, EXP2_8=PB15, EXP2_10=PC9,

    # EXP3 header
    EXP3_1=PC9,  EXP3_3=PC10, EXP3_5=PC11, EXP3_7=PB12, EXP3_9=<GND>,
    EXP3_2=PC12, EXP3_4=PB14, EXP3_6=PB13, EXP3_8=PB15, EXP3_10=<5V>
    # Pins EXP1_4, EXP1_8, EXP1_6 are also MISO, MOSI, SCK of bus "spi2"

# See the sample-lcd.cfg file for definitions of common LCD displays.
