FYSETC/FYSETC-Cheetah-v2/(commit log)

2021-11-30 Add firmware
    [Configuration.h, Configuration_adv.h, esp32.csv, generic-fysetc-cheetah-v2.0.cfg]
2022-02-24 Upload Ender-3 application example
    [Configuration.h, Configuration_adv.h]
2022-03-12 Change BLTOUCH servo pin to PB5
2022-03-22 Upload printer.cfg
    [printer.cfg]
2022-05-17 Add CR10 example
    [Configuration.h, Configuration_adv.h]
2022-08-16 Update default config
    [Configuration.h]
2022-08-16 Add bltouch wiring
2022-08-16 Add Voron0.1 wiring
2024-05-09 Fixed the FGB and PWR-PROBE pins
